ihartwig/ether-friend/README.md

# ether-friend
Custom-purpose and hackable ethernet adapters

[papoe-pi-zero](papoe-pi-zero) Pi Zero HAT with FRC-compatible passive PoE 100M usb-ethernet adapter
