ihartwig/ether-friend/pizero-papoe/datasheets/JLC04162H-3313-stackup.png

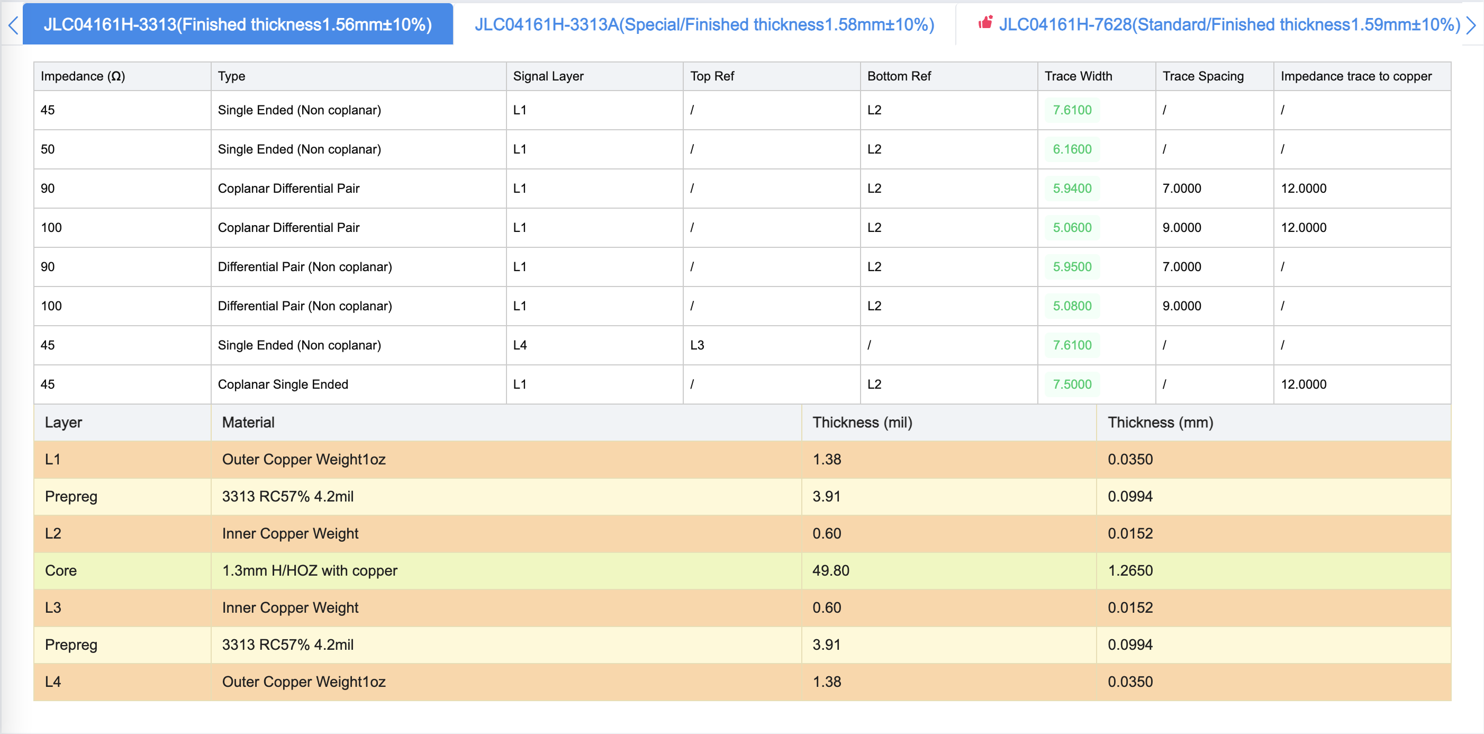
pizero-papoe/datasheets/JLC04162H-3313-stackup.png
