ihartwig/ether-friend/pizero-papoe/pizero-papoe.pdf

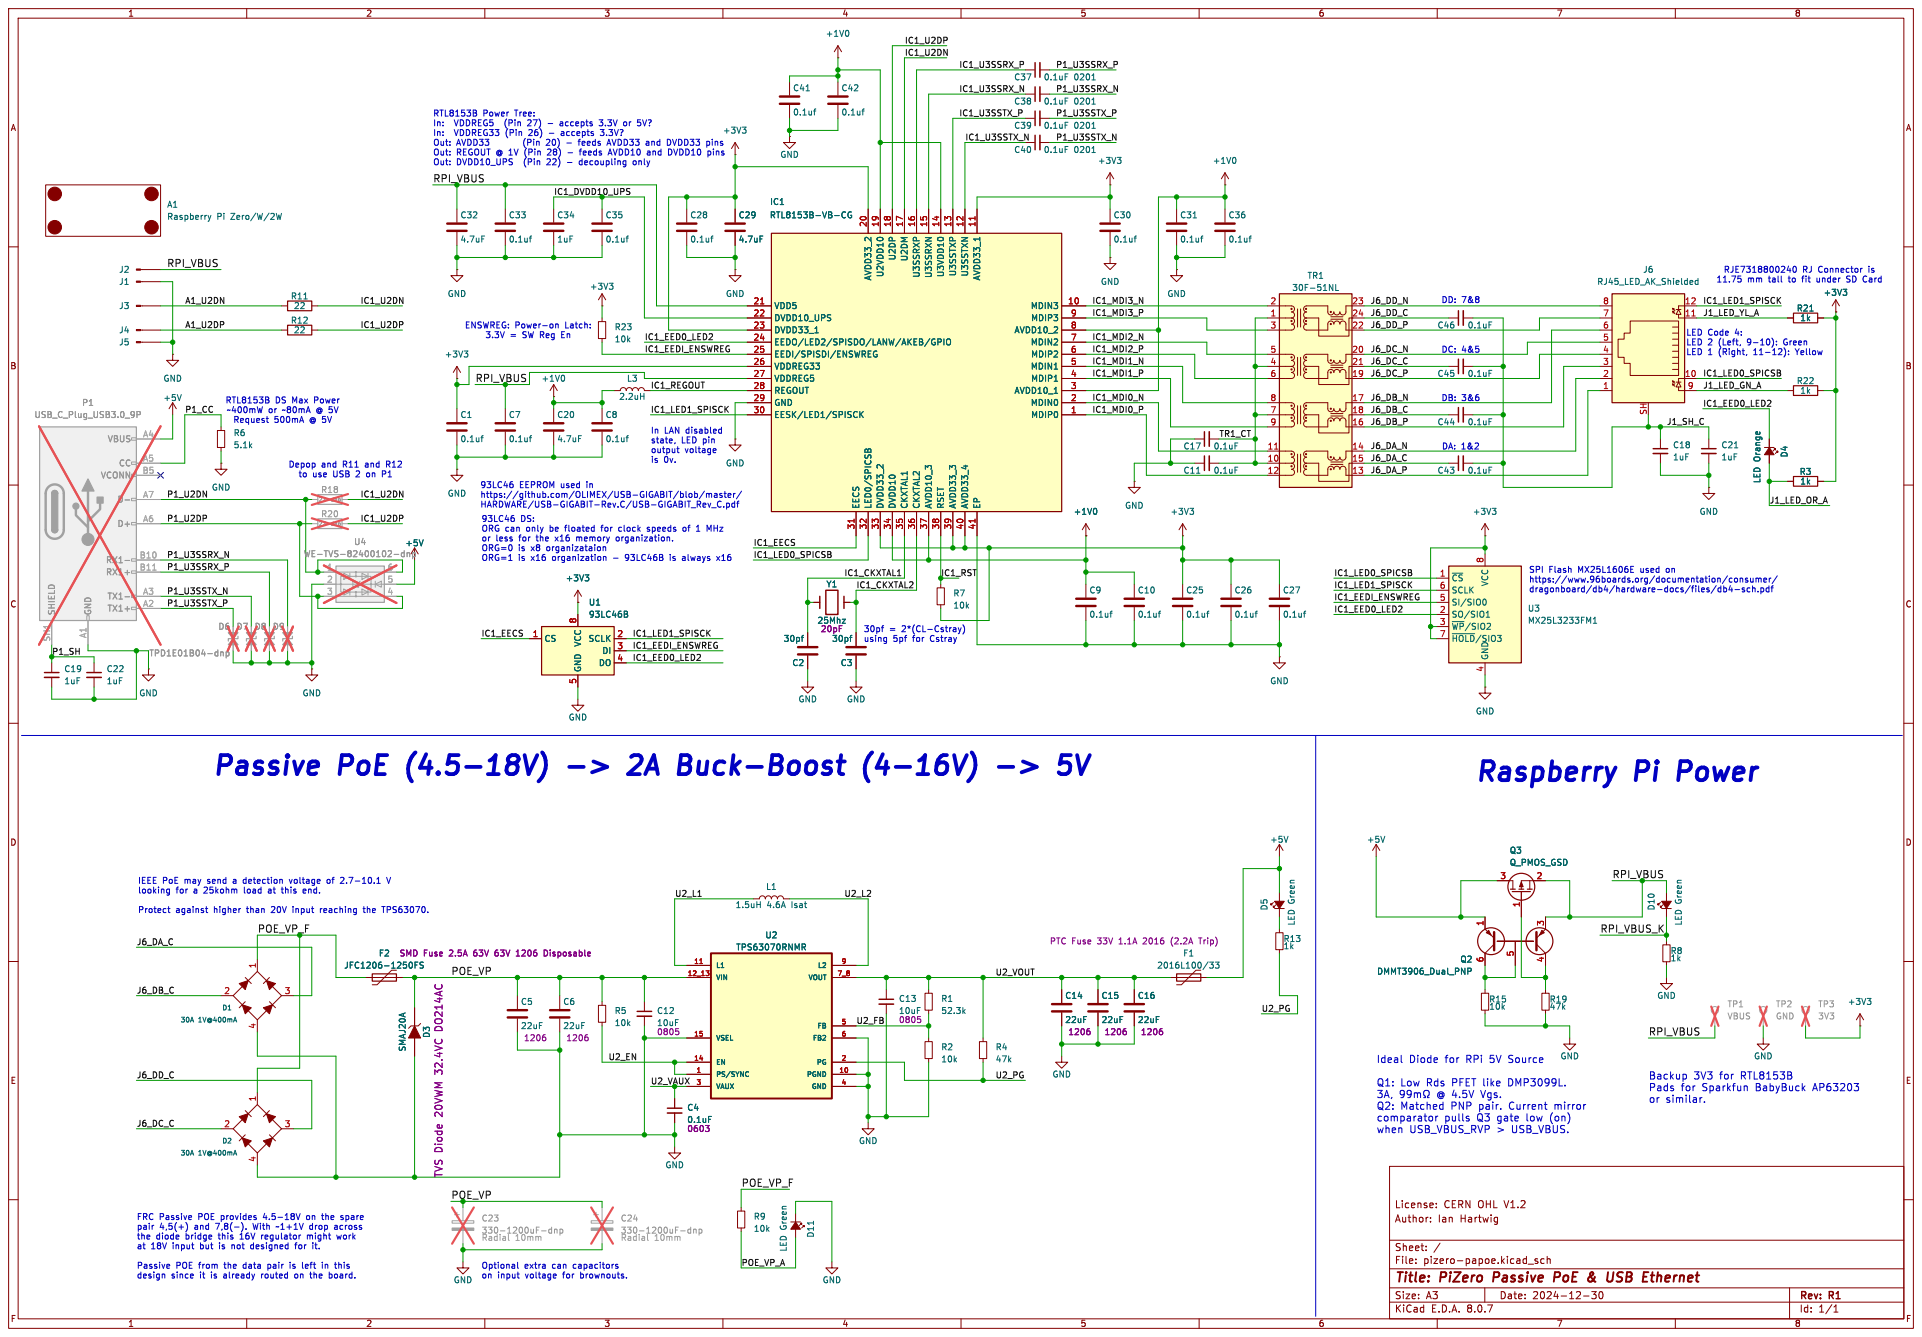
[picture p2: page 1]

93LC46 EEPROM used in
https://github.com/OLIMEX/USB-GIGABIT/blob/master/

4 SI/SIO0 5 SCLK 6 ~{HOLD}/SIO3 7 VCC

https://www.96boards.org/documentation/consumer/
dragonboard/db4/hardware-docs/files/db4-sch.pdf

Ideal Diode for RPi 5V Source

Q1: Low Rds PFET like DMP3099L. 3A, þÿ99m©@ 4.5V Vgs.

Backup 3V3 for RTL8153B
Pads for Sparkfun BabyBuck AP63203
or similar.
