ihartwig/ether-friend/pizero-papoe/asm/gerbers/pizero-papoe-B.Fab.pdf

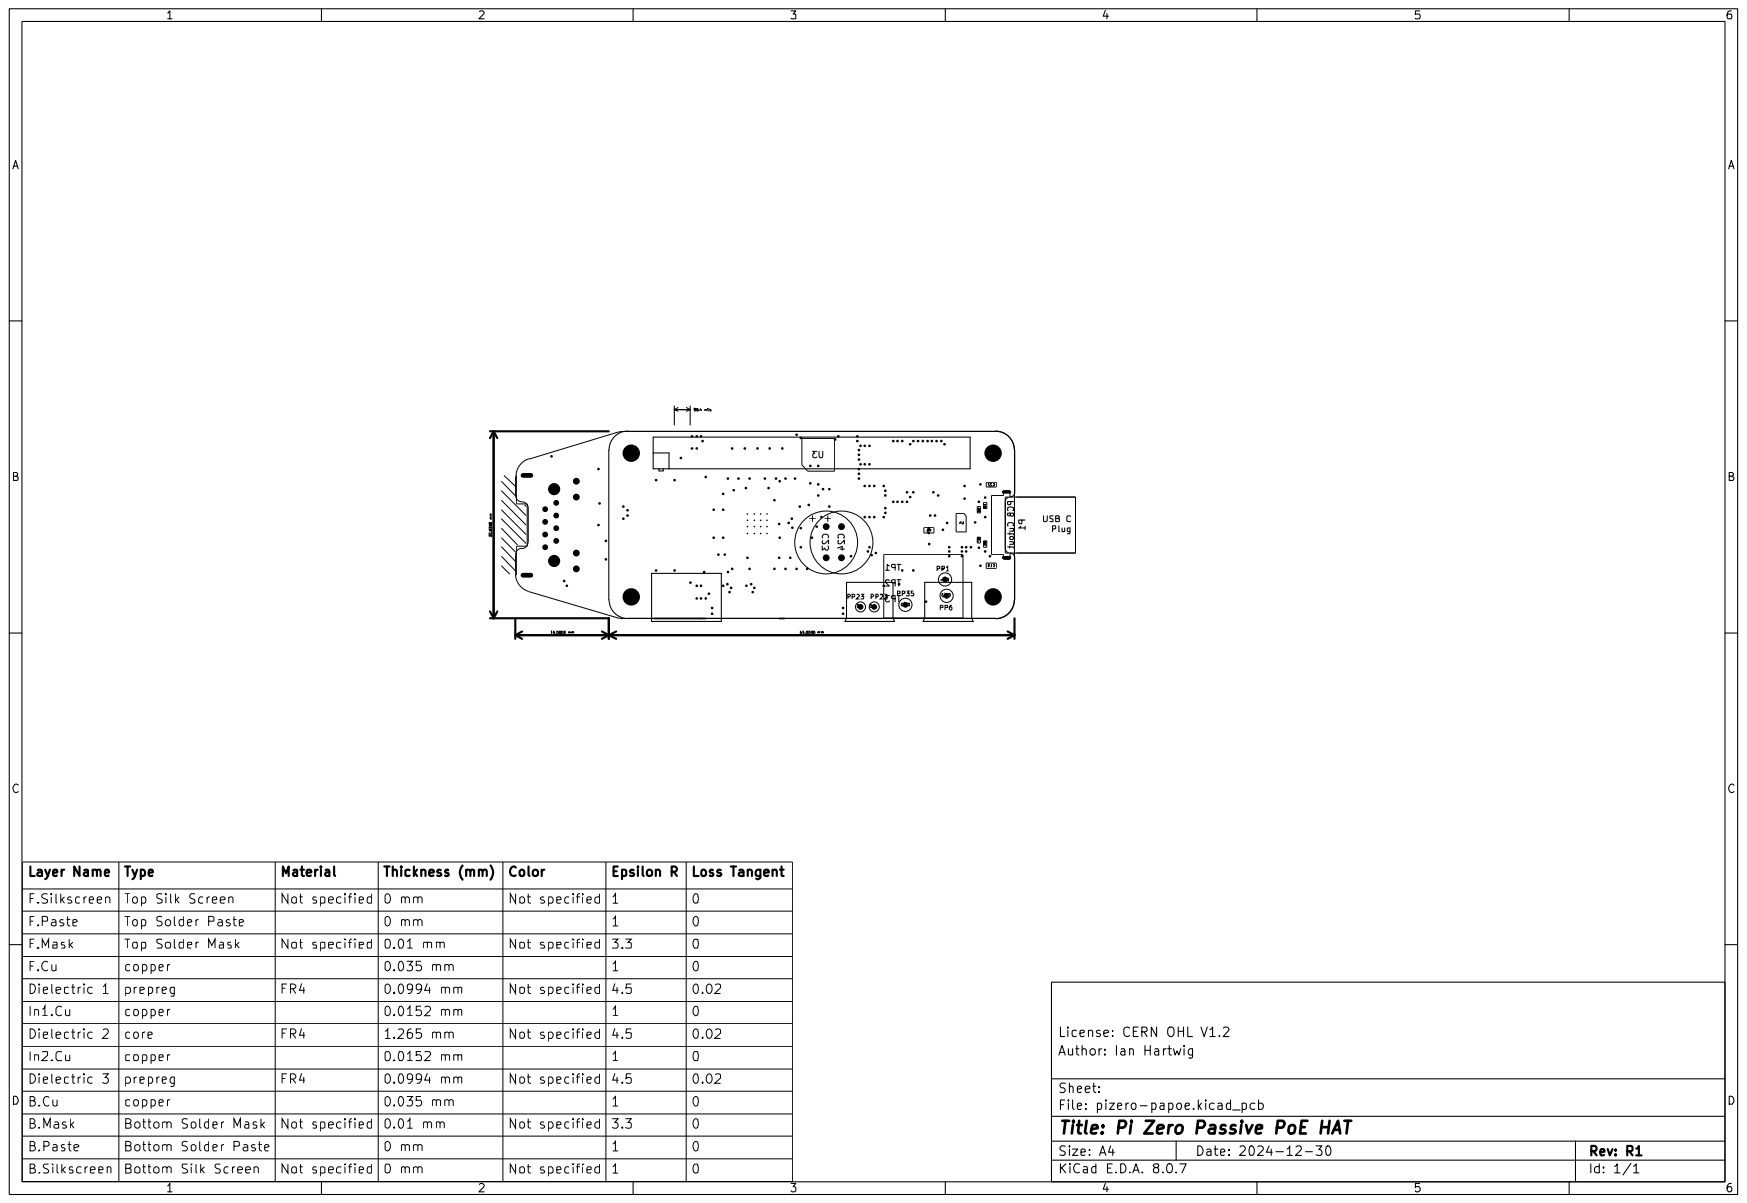
[picture p3: page 1]
