ihartwig/ether-friend/pizero-papoe/asm/gerbers/pizero-papoe-F.Fab.pdf

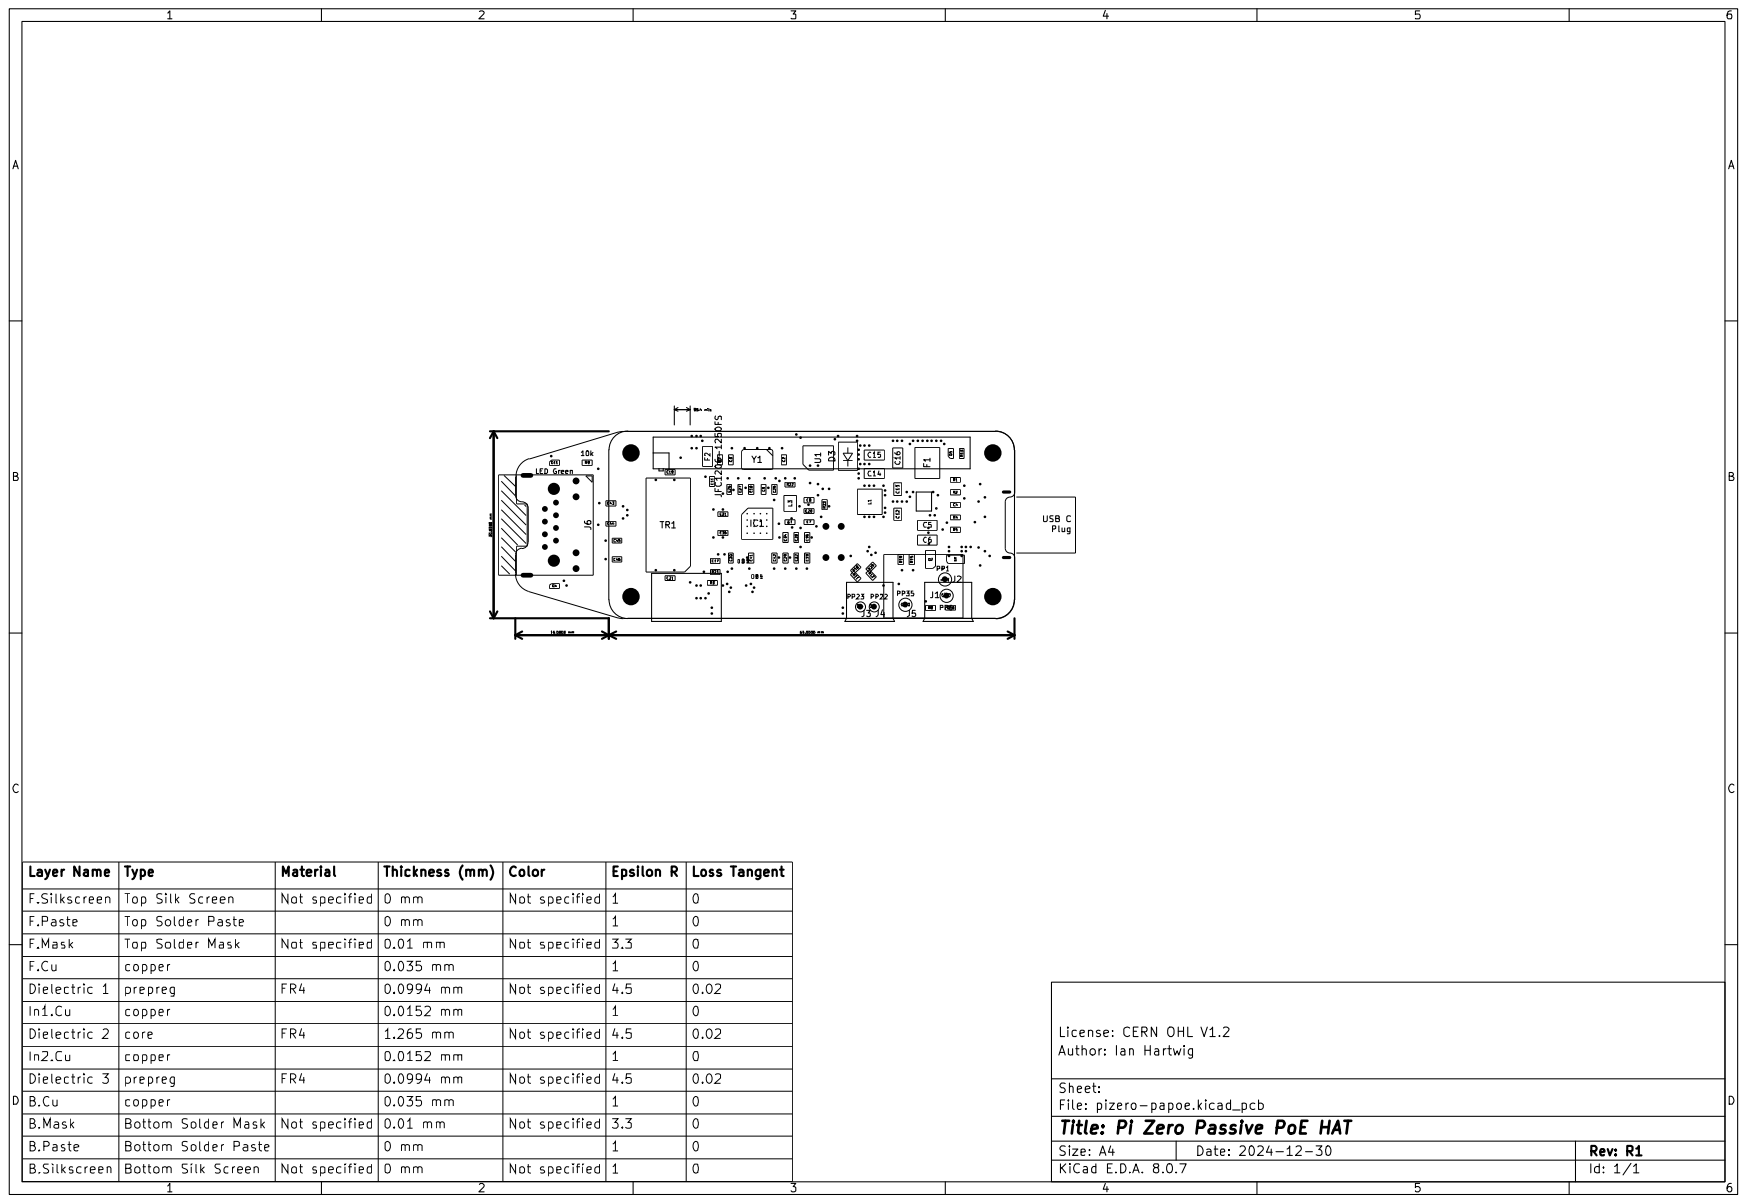
[picture p4: page 1]
