ihartwig/ether-friend/pizero-papoe/pizero-papoe.kicad_pcb

## KiCad design pizero-papoe/pizero-papoe.kicad_pcb (2025-01-02)

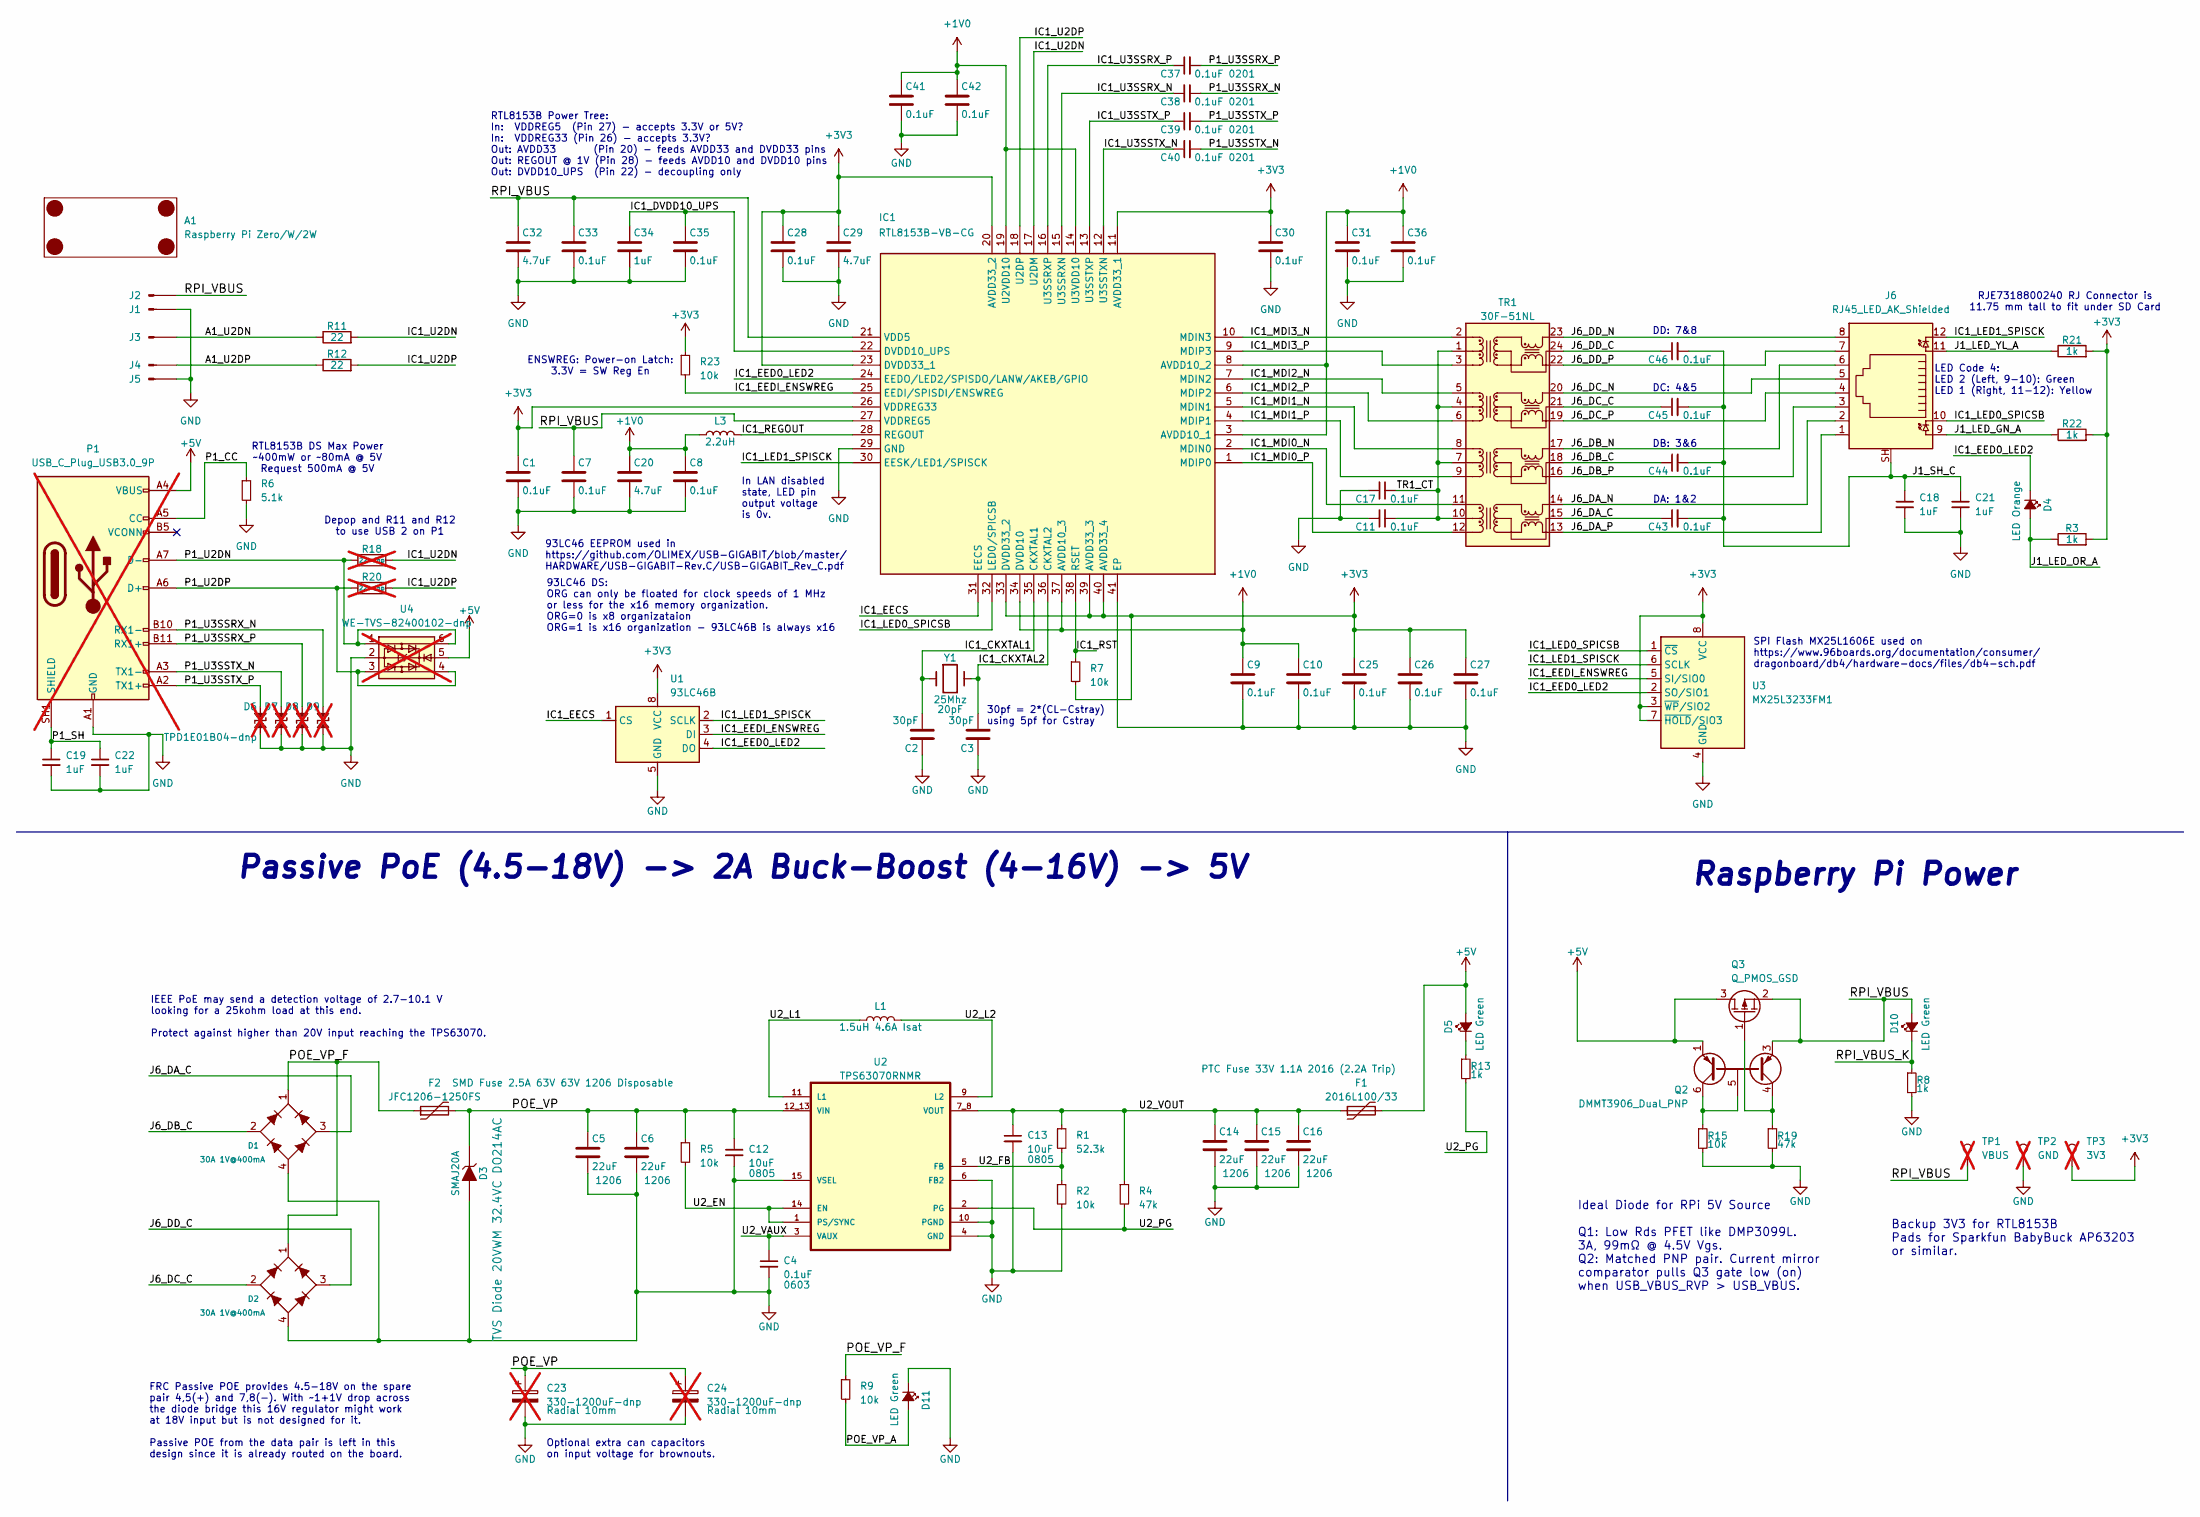
[picture p5: schematic pizero-papoe.kicad_sch, PiZero Passive PoE & USB Ethernet]

Parts:
A1: Raspberry Pi Zero/W/2W; RPi_Zero_ZeroW_Zero2W_Hat_NoPads_NoHeader; LCSC --
C1, C7, C8, C9, C10, C11, C17, C25, C26, C27, C28, C30, C31, C33, C35, C36, C41, C42, C43, C44, C45, C46: 0.1uF; C_0603_1608Metric; LCSC C6119867
C2: 30pF; C_0603_1608Metric; Mfg PN 0603CG300F500NT; LCSC C501847
C3: 30pF; C_0603_1608Metric; LCSC C501847
C4: 0.1uF; C_0603_1608Metric; Mfg Part No CC0603KRX7R7BB104; LCSC C6119867
C5: 22uF; C_1206_3216Metric; Mfg Part No CC1206KKX5R8BB226; LCSC C6119965
C6, C14, C15, C16: 22uF; C_1206_3216Metric; LCSC C6119965
C12: 10uF; C_0805_2012Metric; Mfg Part No GRT21BC71E106KE13L; LCSC C882505
C13: 10uF; C_0805_2012Metric; LCSC C882505
C18, C19, C21, C22, C34: 1uF; C_0603_1608Metric; LCSC C5673
C20, C29, C32: 4.7uF; C_0603_1608Metric; LCSC C6119855
C23, C24: 330-1200uF-dnp; CP_Radial_D10.0mm_P5.00mm; Mfg Part No RNL1E122MDSASQ; not fitted
C37, C38, C39, C40: 0.1uF 0201; C_0201_0603Metric; LCSC C6119757
D1: 30A 1V@400mA; MBS; Mfg Part No HD01-T; Digikey Part No HD01DICT-ND
D2: 30A 1V@400mA; MBS; LCSC C2488
D3: SMAJ20A; D_SMA; Mfg Part No SMAJ20A; LCSC C115250
D4: LED Orange; LED_0603_1608Metric; Mfg Part No LTST-C190KFKT; LCSC C157740
D5, D10, D11: LED Green; LED_0603_1608Metric; Mfg Part No LTST-C190GKT; LCSC C125093
D6: TPD1E01B04-dnp; D_0402_1005Metric; Mfg PN TPD1E01B04DPYR; LCSC C779389; not fitted
D7, D8, D9: TPD1E01B04-dnp; D_0402_1005Metric; LCSC C779389; not fitted
F1: 2016L100/33; Fuse_2016_5041Metric; Mfg Part No 2016L100/33DR; LCSC C207077
F2: JFC1206-1250FS; Fuse_1206_3216Metric; Mfg Part No JFC1206-1250FS; LCSC C136346
IC1: RTL8153B-VB-CG; QFN-40-1EP_5x5mm_P0.4mm_EP3.6x3.6mm_ThermalVias; Mfg PN RTL8153B-VB-CG; LCSC C2802072
J1, J2, J3, J4, J5: PogoPin_01x01; PogoPin_CPG-01-TH-TR; Mfg PN CPG-01-TH-B; LCSC --
J6: RJ45_LED_AK_Shielded; RJ45_Amphenol_RJE7318800xxx0x; Mfg PN RJE7318800240; LCSC --
L1: 1.5uH 4.6A Isat; L_Sunlord_SWPA4030S; Mfg Part No XFL4020-152ME; LCSC C5127390
L3: 2.2uH; L_1008_2520Metric; Mfg Part No SFE252010S-2R2M-HF; LCSC C2986800
P1: USB_C_Plug_USB3.0_9P; USB_C_Plug_G-Switch_GT-USB-8016A_9P_TopMnt_Horizontal; Mfg PN GT-USB-8016A; not fitted
Q2: DMMT3906_Dual_PNP; SOT-23-6; Mfg Part No DMMT3906-7-F; Digikey Part No DMMT3906-7-FDICT-ND
Q3: Q_PMOS_GSD; SOT-23; Mfg Part No DMP3099L-7; Digikey Part No DMP3099L-7DICT-ND
R1: 52.3k; R_0603_1608Metric; LCSC C23198
R2, R5, R7, R9, R15, R23: 10k; R_0603_1608Metric; LCSC C15401
R3, R8, R13, R21, R22: 1k; R_0603_1608Metric; LCSC C21190
R4, R19: 47k; R_0603_1608Metric; LCSC C25600
R6: 5.1k; R_0603_1608Metric; LCSC C26000
R11, R12: 22; R_0603_1608Metric; LCSC C1203
R18, R20: 22-dnp; R_0603_1608Metric; not fitted
TP1: VBUS; TestPoint_Pad_D1.5mm; not fitted
TP2: GND; TestPoint_Pad_D1.5mm; not fitted
TP3: 3V3; TestPoint_Pad_D1.5mm; not fitted
TR1: 30F-51NL; Transformer_Ethernet_YDS_30F-51NL_SO-24_7.1x15.1mm; LCSC C123168
U1: 93LC46B; SOIC-8_3.9x4.9mm_P1.27mm; Mfg Pn 93LC46B/SN; LCSC C1348804
U2: TPS63070RNMR; VREG_TPS63070RNMR; Mfg Part No TPS63070RNMR; LCSC C109322
U3: MX25L3233FM1; SOP-8_5.28x5.23mm_P1.27mm; Mfg PN MX25L1606EM2I-12G; LCSC C415878
U4: WE-TVS-82400102-dnp; SOT-23-6; not fitted
Y1: 25Mhz; Crystal_SMD_5032-2Pin_5.0x3.2mm; Mfg Part No 445I23D25M00000; Digikey Part No CTX1175CT-ND

Connections:
+1V0: C8.1, C9.1, C10.1, C20.1, C31.1, C36.1, C41.1, C42.1, IC1.3 (AVDD10_1), IC1.8 (AVDD10_2), IC1.14 (U3VDD10), IC1.19 (U2VDD10), IC1.34 (DVDD10), IC1.37 (AVDD10_3), L3.1
+3V3: C1.1, C25.1, C26.1, C27.1, C28.1, C29.1, C30.1, IC1.11 (AVDD33_1), IC1.20 (AVDD33_2), IC1.23 (DVDD33_1), IC1.26 (VDDREG33), IC1.33 (DVDD33_2), IC1.39 (AVDD33_3), IC1.40 (AVDD33_4), R3.2, R7.2, R21.2, R22.2, R23.1, TP3.1, U1.8 (VCC), U3.3 (~WP/SIO2), U3.7 (~HOLD/SIO3), U3.8 (VCC)
+5V: D5.2 (A), F1.2, P1.A4 (VBUS), P1.A9 (VBUS), P1.B4 (VBUS), P1.B9 (VBUS), Q2.1 (E1), Q3.3 (D), U4.5
/A1_U2DN: J3.1, R11.1
/A1_U2DP: J4.1, R12.1
/IC1_CKXTAL1: C2.2, IC1.35 (CKXTAL1), Y1.1
/IC1_CKXTAL2: C3.2, IC1.36 (CKXTAL2), Y1.2
/IC1_DVDD10_UPS: C34.1, C35.1, IC1.22 (DVDD10_UPS)
/IC1_EECS: IC1.31 (EECS), U1.1 (CS)
/IC1_EED0_LED2: D4.1 (K), IC1.24 (EEDO/LED2/SPISDO/LANW/AKEB/GPIO), U1.4 (DO), U3.2 (SO/SIO1)
/IC1_EEDI_ENSWREG: IC1.25 (EEDI/SPISDI/ENSWREG), R23.2, U1.3 (DI), U3.5 (SI/SIO0)
/IC1_LED0_SPICSB: IC1.32 (LED0/SPICSB), J6.10, U3.1 (~CS)
/IC1_LED1_SPISCK: IC1.30 (EESK/LED1/SPISCK), J6.12, U1.2 (SCLK), U3.6 (SCLK)
/IC1_MDI0_N: IC1.2 (MDIN0), TR1.11 (TD4+)
/IC1_MDI0_P: IC1.1 (MDIP0), TR1.12 (TD4-)
/IC1_MDI1_N: IC1.5 (MDIN1), TR1.8 (TD3+)
/IC1_MDI1_P: IC1.4 (MDIP1), TR1.9 (TD3-)
/IC1_MDI2_N: IC1.7 (MDIN2), TR1.5 (TD2+)
/IC1_MDI2_P: IC1.6 (MDIP2), TR1.6 (TD2-)
/IC1_MDI3_N: IC1.10 (MDIN3), TR1.2 (TD1+)
/IC1_MDI3_P: IC1.9 (MDIP3), TR1.3 (TD1-)
/IC1_REGOUT: IC1.28 (REGOUT), L3.2
/IC1_RST: IC1.38 (RSET), R7.1
/IC1_U2DN: IC1.17 (U2DM), R11.2, R18.2
/IC1_U2DP: IC1.18 (U2DP), R12.2, R20.2
/IC1_U3SSRX_N: C38.1, IC1.15 (U3SSRXN)
/IC1_U3SSRX_P: C37.1, IC1.16 (U3SSRXP)
/IC1_U3SSTX_N: C40.1, IC1.12 (U3SSTXN)
/IC1_U3SSTX_P: C39.1, IC1.13 (U3SSTXP)
/J1_LED_GN_A: J6.9, R22.1
/J1_LED_OR_A: D4.2 (A), R3.1
/J1_LED_YL_A: J6.11, R21.1
/J1_SH_C: C18.1, C21.1, C43.2, C44.2, C45.2, C46.2, J6.SH
/J6_DA_C: C43.1, D1.3 (~2), TR1.15 (CT)
/J6_DA_N: J6.2, TR1.14 (MX4+)
/J6_DA_P: J6.1, TR1.13 (MX4-)
/J6_DB_C: C44.1, D1.2 (~1), TR1.18 (CT)
/J6_DB_N: J6.6, TR1.17 (MX3+)
/J6_DB_P: J6.3, TR1.16 (MX3-)
/J6_DC_C: C45.1, D2.2 (~1), TR1.21 (CT)
/J6_DC_N: J6.5, TR1.20 (MX2+)
/J6_DC_P: J6.4, TR1.19 (MX2-)
/J6_DD_C: C46.1, D2.3 (~2), TR1.24 (CT)
/J6_DD_N: J6.8, TR1.23 (MX1+)
/J6_DD_P: J6.7, TR1.22 (MX1-)
/P1_CC: P1.A5 (CC), R6.1
/P1_SH: C19.1, C22.1, P1.SH1 (SHIELD)
/P1_U2DN: P1.A7 (D-), R18.1, U4.1, U4.6
/P1_U2DP: P1.A6 (D+), R20.1, U4.3, U4.4
/P1_U3SSRX_N: C38.2, D9.1 (A1), P1.B10 (RX1-)
/P1_U3SSRX_P: C37.2, D8.1 (A1), P1.B11 (RX1+)
/P1_U3SSTX_N: C40.2, D7.1 (A1), P1.A3 (TX1-)
/P1_U3SSTX_P: C39.2, D6.1 (A1), P1.A2 (TX1+)
/POE_VP: C5.1, C6.1, C12.1, C23.1, C24.1, D3.1 (K), F2.2, R5.1, U2.12_13 (VIN)
/POE_VP_A: D11.2 (A), R9.2
/POE_VP_F: D1.1 (V+), D2.1 (V+), F2.1, R9.1
/RPI_VBUS: C7.1, C32.1, C33.1, D10.2 (A), IC1.21 (VDD5), IC1.27 (VDDREG5), J2.1, Q2.3 (E2), Q3.2 (S), TP1.1
/RPI_VBUS_K: D10.1 (K), R8.1
/TR1_CT: C11.2, C17.2, TR1.1 (CT), TR1.4 (CT), TR1.7 (CT), TR1.10 (CT)
/U2_EN: R5.2, U2.1 (PS/SYNC), U2.14 (EN)
/U2_FB: R1.2, R2.1, U2.5 (FB)
/U2_L1: L1.1, U2.11 (L1)
/U2_L2: L1.2, U2.9 (L2)
/U2_PG: R4.2, R13.2, U2.2 (PG)
/U2_VAUX: C4.1, U2.3 (VAUX)
/U2_VOUT: C13.1, C14.1, C15.1, C16.1, F1.1, R1.1, R4.1, U2.7_8 (VOUT)
GND: C1.2, C2.1, C3.1, C4.2, C5.2, C6.2, C7.2, C8.2, C9.2, C10.2, C11.1, C12.2, C13.2, C14.2, C15.2, C16.2, C17.1, C18.2, C19.2, C20.2, C21.2, C22.2, C23.2, C24.2, C25.2, C26.2, C27.2, C28.2, C29.2, C30.2, C31.2, C32.2, C33.2, C34.2, C35.2, C36.2, C41.2, C42.2, D1.4 (V-), D2.4 (V-), D3.2 (A), D6.2 (A2), D7.2 (A2), D8.2 (A2), D9.2 (A2), D11.1 (K), IC1.29 (GND), IC1.41 (EP), J1.1, J5.1, P1.A1 (GND), P1.A12 (GND), P1.B1 (GND), P1.B12 (GND), R2.2, R6.2, R8.2, R15.2, R19.2, TP2.1, U1.5 (GND), U2.4 (GND), U2.6 (FB2), U2.10 (PGND), U2.15 (VSEL), U3.4 (GND), U4.2
unnamed: D5.1 (K), R13.1
unnamed: Q2.5 (B), Q2.6 (C1), R15.1
unnamed: Q2.4 (C2), Q3.1 (G), R19.1

Notes on the sheet:
DC: 4&5
Depop and R11 and R12 to use USB 2 on P1
RTL8153B Power Tree: In: VDDREG5 (Pin 27) - accepts 3.3V or 5V? In: VDDREG33 (Pin 26) - accepts 3.3V? Out: AVDD33 (Pin 20) - feeds AVDD33 and DVDD33 pins Out: REGOUT @ 1V (Pin 28) - feeds AVDD10 and DVDD10 pins Out: DVDD10_UPS (Pin 22) - decoupling only
IEEE PoE may send a detection voltage of 2.7-10.1 V looking for a 25kohm load at this end. Protect against higher than 20V input reaching the TPS63070.
RTL8153B DS Max Power ~400mW or ~80mA @ 5V Request 500mA @ 5V
RJE7318800240 RJ Connector is 11.75 mm tall to fit under SD Card
ENSWREG: Power-on Latch: 3.3V = SW Reg En
Passive PoE (4.5-18V) -> 2A Buck-Boost (4-16V) -> 5V
In LAN disabled state, LED pin output voltage is 0v.
30pf = 2*(CL-Cstray) using 5pf for Cstray
DD: 7&8
Raspberry Pi Power
SPI Flash MX25L1606E used on https://www.96boards.org/documentation/consumer/ dragonboard/db4/hardware-docs/files/db4-sch.pdf
Ideal Diode for RPi 5V Source Q1: Low Rds PFET like DMP3099L. 3A, 99mΩ @ 4.5V Vgs. Q2: Matched PNP pair. Current mirror comparator pulls Q3 gate low (on) when USB_VBUS_RVP > USB_VBUS.
DA: 1&2
DB: 3&6
93LC46 EEPROM used in https://github.com/OLIMEX/USB-GIGABIT/blob/master/ HARDWARE/USB-GIGABIT-Rev.C/USB-GIGABIT_Rev_C.pdf
Backup 3V3 for RTL8153B Pads for Sparkfun BabyBuck AP63203 or similar.
FRC Passive POE provides 4.5-18V on the spare pair 4,5(+) and 7,8(-). With ~1+1V drop across the diode bridge this 16V regulator might work at 18V input but is not designed for it. Passive POE from the data pair is left in this design since it is already routed on the board.
93LC46 DS: ORG can only be floated for clock speeds of 1 MHz or less for the x16 memory organization. ORG=0 is x8 organizataion ORG=1 is x16 organization - 93LC46B is always x16
Optional extra can capacitors on input voltage for brownouts.
LED Code 4: LED 2 (Left, 9-10): Green LED 1 (Right, 11-12): Yellow

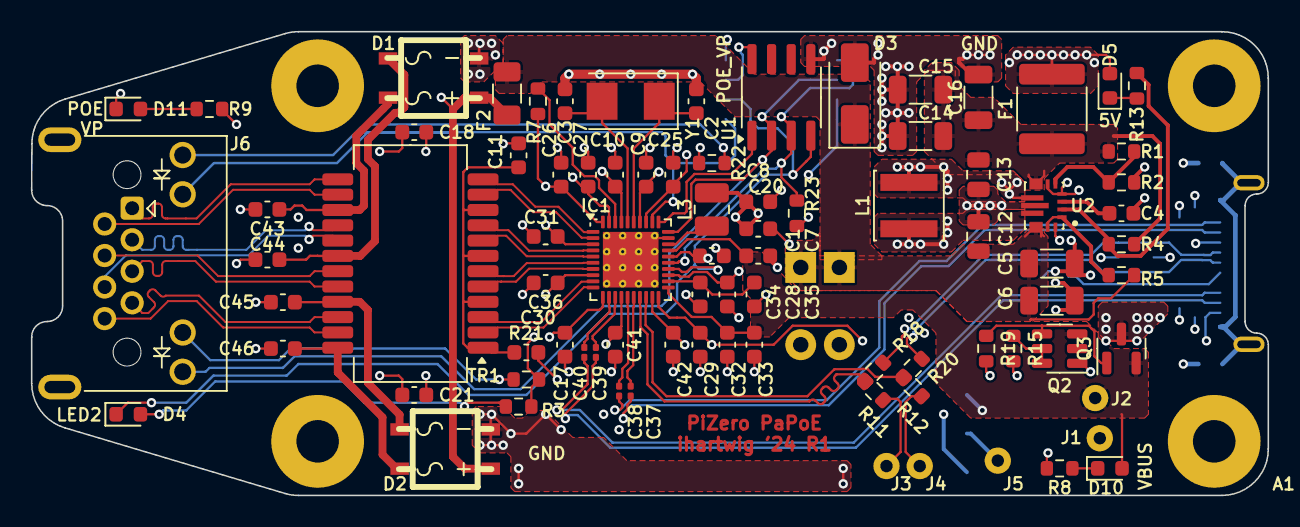
[picture p6: board pizero-papoe.kicad_pcb from above]

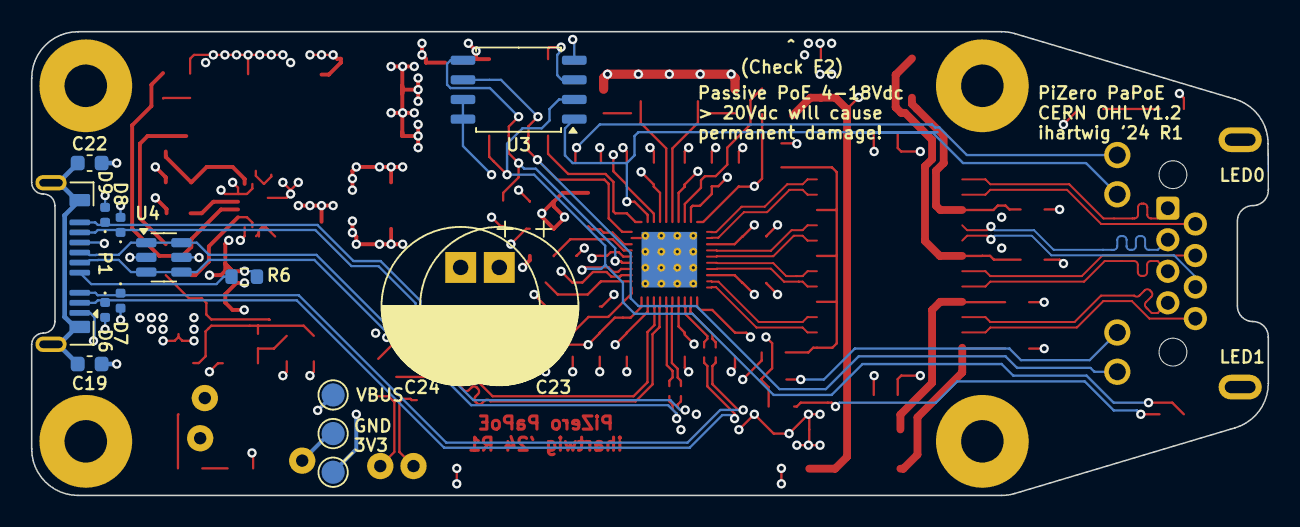
[picture p7: board pizero-papoe.kicad_pcb from below]

Board: 4 copper layers, 80.0 x 30.0 mm, 100 parts (15 on the bottom side), 70 nets.
