ihartwig/ether-friend/(commit log)

2024-12-08 move papoe-pi-zero from PoEPi-hardware/passive-poe-only-top-smt
    [pizero-papoe-B_Cu.gbl, pizero-papoe-B_Mask.gbs, pizero-papoe-B_Paste.gbp, pizero-papoe-B_Silkscreen.gbo, pizero-papoe-Edge_Cuts.gm1, pizero-papoe-F_Cu.gtl, pizero-papoe-F_Mask.gts, pizero-papoe-F_Paste.gtp]
2024-12-08 papoe-pi-zero -> pizero-papoe
    [pizero-papoe-B_Cu.gbl, pizero-papoe-B_Mask.gbs, pizero-papoe-B_Paste.gbp, pizero-papoe-B_Silkscreen.gbo, pizero-papoe-Edge_Cuts.gm1, pizero-papoe-F_Cu.gtl, pizero-papoe-F_Mask.gts, pizero-papoe-F_Paste.gtp]
2024-12-22 sch updates for RTL8153B and RJE7318800240
    [pizero-papoe.kicad_pcb, pizero-papoe.kicad_sch]
2024-12-27 complete RTL8153B sch
    [pizero-papoe.kicad_pcb, pizero-papoe.kicad_sch]
2024-12-30 pcb routing for RTL8153B and RJE7318800240
    [pizero-papoe.kicad_pcb, pizero-papoe.kicad_sch]
2024-12-30 add JLC04162H-3313-stackup info
    [pizero-papoe.kicad_pcb]
2024-12-31 pizero-papoe sch pcb fixes and cleanup
    [pizero-papoe.kicad_pcb, pizero-papoe.kicad_sch]
2024-12-31 pizero-papoe generate gerbers
    [pizero-papoe-B_Cu.gbl, pizero-papoe-B_Mask.gbs, pizero-papoe-B_Paste.gbp, pizero-papoe-B_Silkscreen.gbo, pizero-papoe-Edge_Cuts.gm1, pizero-papoe-F_Cu.gtl, pizero-papoe-F_Mask.gts, pizero-papoe-F_Paste.gtp]
2025-01-02 pizero-papoe pcb sch bom tweaks for r1
    [pizero-papoe-B_Cu.gbl, pizero-papoe-B_Mask.gbs, pizero-papoe-B_Paste.gbp, pizero-papoe-B_Silkscreen.gbo, pizero-papoe-Edge_Cuts.gm1, pizero-papoe-F_Cu.gtl, pizero-papoe-F_Mask.gts, pizero-papoe-F_Paste.gtp]
2025-01-21 add pizero-papoe bom info and step export
    [pizero-papoe.kicad_sch]
