ihartwig/ether-friend/(notices)

Notices in the files:
pizero-papoe/pizero-papoe.kicad_sch:
License: CERN OHL V1.2
pizero-papoe/pizero-papoe.kicad_pcb:
CERN OHL V1.2
